AliRah1/lijn-volgende-robot/alirahhaoui_logboek_q6.pdf

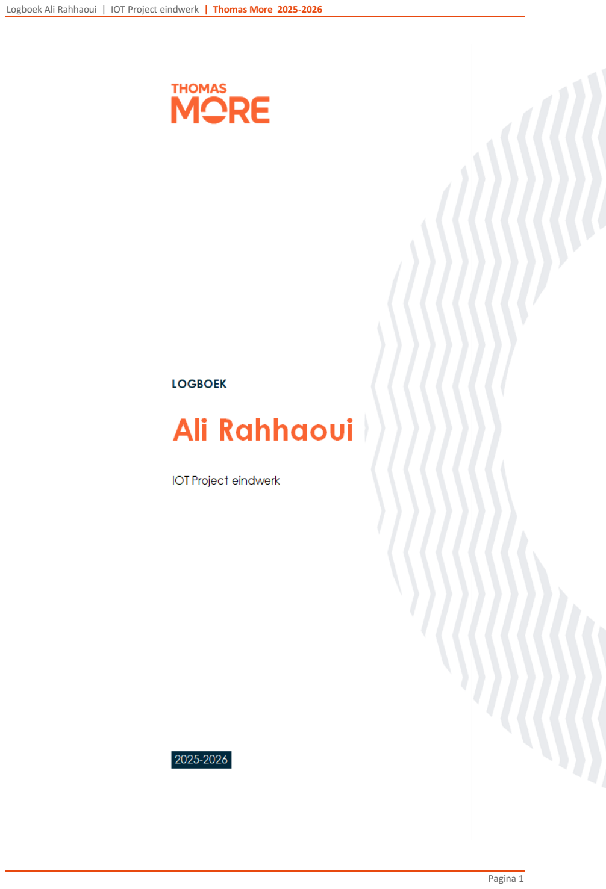
[picture p8: page 1]

Logboek Ali Rahhaoui | IOT Project eindwerk | Thomas More 2025-2026

## Instructies

Vul dit logboek 2x per week aan: elke dinsdag en vrijdag.

Wat er wordt gevraagd:

- Wat heb ik gedaan?
- Wat ging goed?
- Wat zou ik nu anders doen?
- Wat heb ik bijgeleerd?
- Wat plan ik de volgende periode te doen?

## 13. Vrijdag 5 juni 2026

Wat heb ik gedaan?
Alles getest en alles werkt. Nu nog wachten tot de examendag zelf.

Wat ging goed?
Alles ging goed zoals gepland.

Wat zou ik nu anders doen? /

Wat heb ik bijgeleerd?
/

Wat plan ik de volgende periode te doen? Presenteren op school.

## 12. Dinsdag 2 juni 2026

Wat heb ik gedaan?
Ik ben van start gegaan met het inladen van de huidige code op de ESP. En ook het klaarzetten van het Raspberry Pi.

Wat ging goed?
Alles ging in orde zoals gepland.

Wat zou ik nu anders doen?
/

Wat heb ik bijgeleerd?
/

Wat plan ik de volgende periode te doen? Alles nakijken, demo video maken en klaar.

## 11. Vrijdag 29 mei 2026

Wat heb ik gedaan?
Vandaag hebben we de diodes gekregen en zijn gestart met het solderen ervan.

Wat ging goed?
We zijn erna gaan testen en deze keer werkten de motoren wel en was alles in orde.

Wat zou ik nu anders doen?
/

Wat heb ik bijgeleerd?
/

Wat plan ik de volgende periode te doen?
Het Raspberry Pi klaarzetten en de juiste code toevoegen voor het robotje.

## 10. Dinsdag 26 mei 2026

Wat heb ik gedaan?
Het component is aangekomen en nu gaan we starten met het te solderen.

Wat ging goed?
Deze keer hebben we het juiste component dus is het in orde.

Wat zou ik nu anders doen?
Kijken wat nog meer ontbrak: we hebben 4 diodes nog nodig en nu moeten we weer wachten voor we opnieuw kunnen testen.

Wat heb ik bijgeleerd?
Dat ik als iets ontbreekt niet alleen naar één kant kijk, maar dat ik ook moet kijken wat ik nog meer nodig heb.

Wat plan ik de volgende periode te doen?
Als we de diodes hebben gaan we van start met het testen, en daarna het Raspberry Pi toevoegen en de juiste code op de ESP.

## 9. Vrijdag 22 mei 2026

Wat heb ik gedaan?
We zijn gestart met het testen van de PCB.

Wat ging goed?
Alle sensoren werken zoals het hoort.

Wat zou ik nu anders doen?
We hebben een verkeerde motor L298N besteld: we hadden het kant-en-klare kit gekocht terwijl we alleen de chip nodig hadden. Hierdoor werkt de PCB niet correct om de motor aan te sturen.

Wat heb ik bijgeleerd?
Altijd eerst goed bekijken wat je bestelt voor het componenten koopt.

Wat plan ik de volgende periode te doen?
We hebben de chip besteld en nu zijn we aan het wachten tot die aankomt.

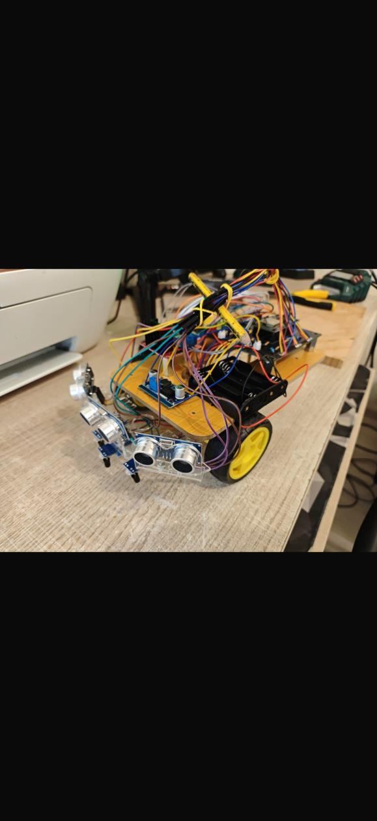
[picture p9: figure]

## 8. Dinsdag 19 mei 2026

Wat heb ik gedaan?
Ik en mijn teamlid zijn gestart met het solderen.

Wat ging goed?
Alles ging in orde.

Wat zou ik nu anders doen?
Beter geweest zijn om een soldeerstation thuis te hebben om veel tijd te besparen.

Wat heb ik bijgeleerd?
Hoe ik efficiënter moet solderen, want solderen is nog nieuw voor mij.

Wat plan ik de volgende periode te doen?
Na het solderen gaan we starten met het testen van de PCB.

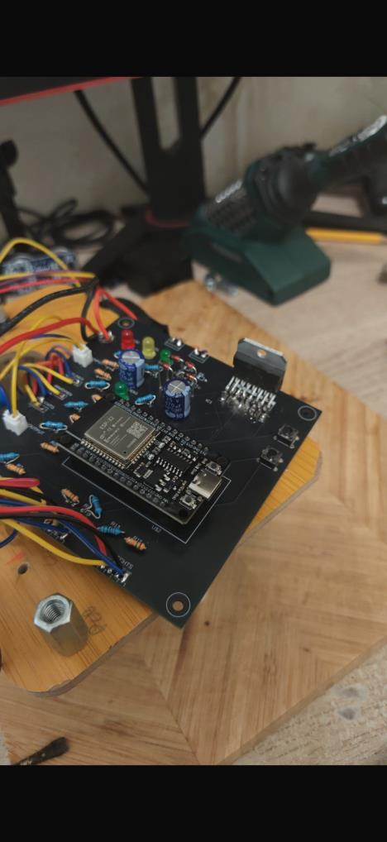
[picture p10: figure]

## 7. Vrijdag 15 mei 2026

Wat heb ik gedaan?
Vandaag is de PCB aangekomen maar we kunnen die nog niet solderen.

Wat ging goed?
/

Wat zou ik nu anders doen? /

Wat heb ik bijgeleerd?
/

Wat plan ik de volgende periode te doen?
We gaan volgende week van start gaan om te solderen.

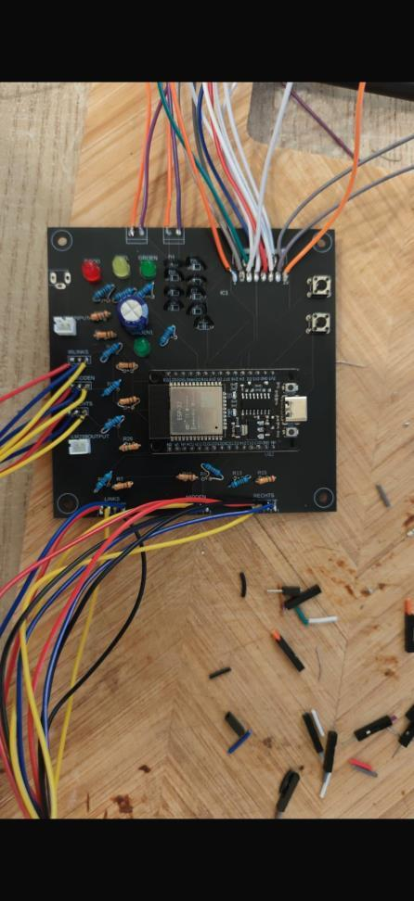
[picture p11: figure]

## 6. Dinsdag 12 mei 2026

Wat heb ik gedaan?
Ik en mijn teamlid zijn van start gegaan met het maken van het chassis, nu dat we toch aan het wachten zijn op de PCB.

Wat ging goed?
Alles ging in orde, we hadden de spullen die we nodig hadden om de taak uit te voeren.

Wat zou ik nu anders doen?
Niets, vandaag ging alles redelijk vlot.

Wat heb ik bijgeleerd?
/

Wat plan ik de volgende periode te doen?
Nu gaan we wachten op de PCB en als die aankomt, deze maken.

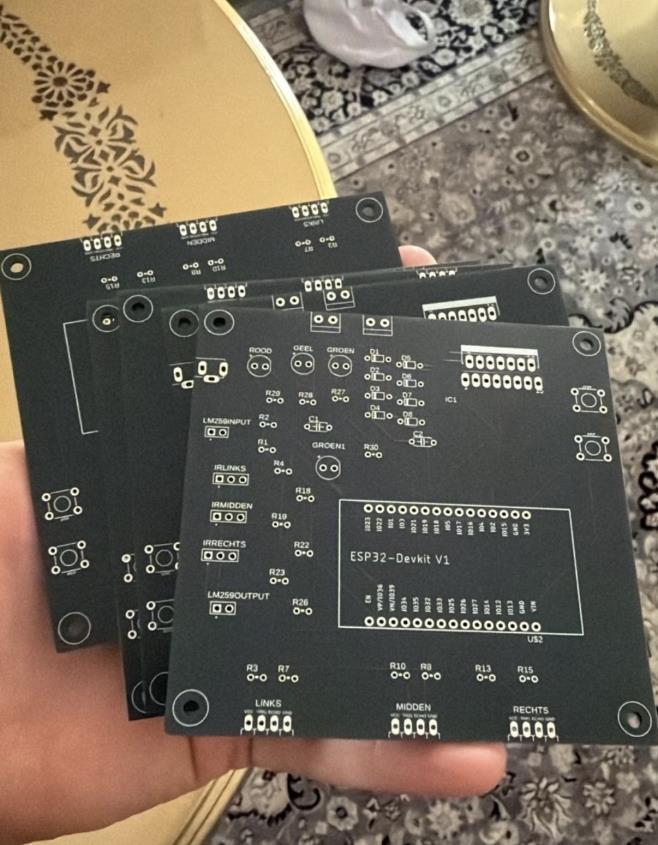
[picture p12: figure]

## 5. 08 mei 2026

Wat heb ik gedaan?
Ik heb goedkeuring gekregen van de leerkracht en heb de PCB besteld.

Wat ging goed?
De PCB was in orde.

Wat zou ik nu anders doen?
Ik zou beter de PCB samen met groepsleden hebben gekocht die het ook wilden, zo vermijden we extra kosten.

Wat heb ik bijgeleerd?
Dat het heel duur is om PCB's te kopen.

Wat plan ik de volgende periode te doen?
Ik en mijn teamlid gaan verder met het chassis en proberen af te maken voor de PCB aankomt, zodat we daarna alleen de PCB nog in orde moeten brengen.

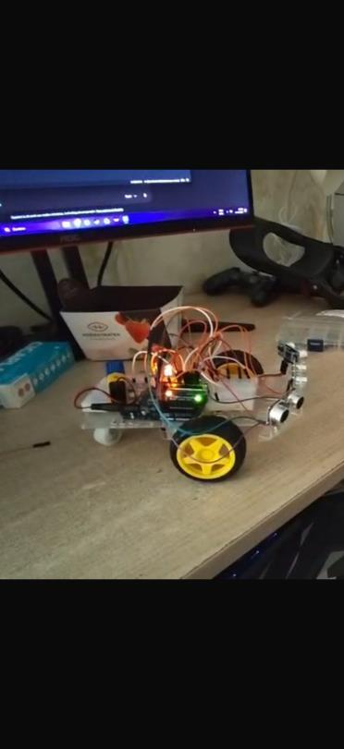
[picture p13: figure]

## 4. Dinsdag 5 mei 2026

Wat heb ik gedaan?
Ik heb de PCB afgekregen en nu wachten wij op de goedkeuring van de leerkracht.

Wat ging goed?
We hebben alles nagecheckt en goed nagekeken of alles in orde was en dat was ook zo.

Wat zou ik nu anders doen?
Niets, alles ging volgens plan.

Wat heb ik bijgeleerd?
Hoe ik PCB-draden groter kan maken en dat componentenplaatsing heel belangrijk is.

Wat plan ik de volgende periode te doen?
Als het goedgekeurd is, plan ik de PCB te bestellen.

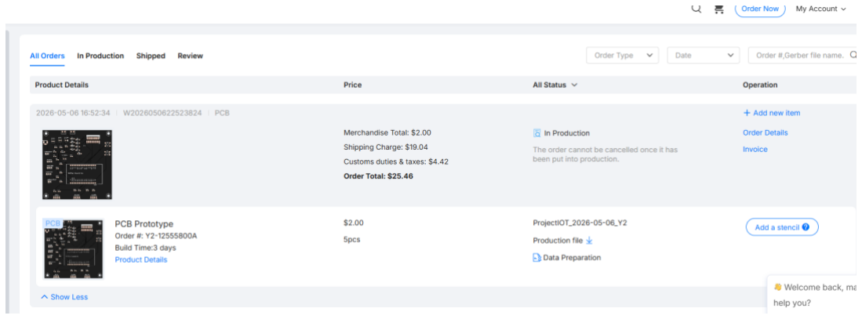
[picture p14: figure]

## 3. Vrijdag 1 mei 2026

Wat heb ik gedaan?
We hebben vandaag onze componenten gekregen en we zijn ons schema aan het verbeteren.

Wat ging goed?
Onze spullen zijn aangekomen dus kunnen we al van start gaan met het autootje op te bouwen.

Wat zou ik nu anders doen?
Niets.

Wat heb ik bijgeleerd?
Dat ik minder weerstanden moet zetten bij het schema.

Wat plan ik de volgende periode te doen?
Starten met de PCB en afwachten op de goedkeuring van de leerkracht.

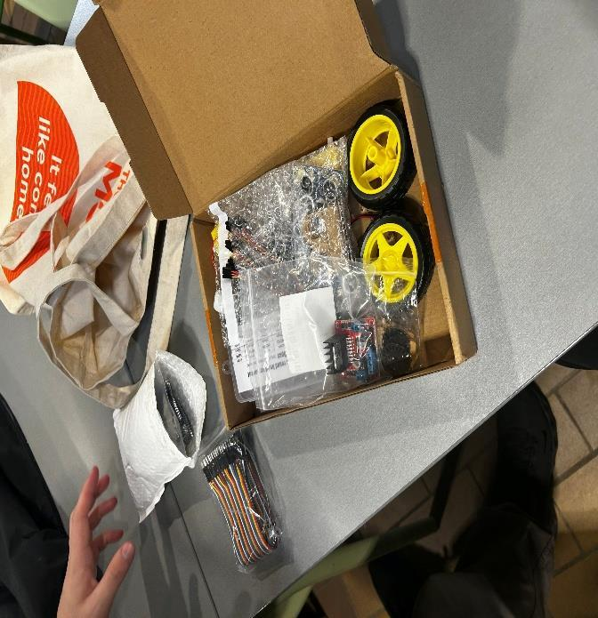
[picture p15: figure]

## 2. Dinsdag 28 april 2025

Wat heb ik gedaan?
We zijn gestart met het maken van een schema.

Wat ging goed?
We hebben alle componenten erop gekregen.

Wat zou ik nu anders doen?
Op voorhand misschien extra datasheets openen.

Wat heb ik bijgeleerd?
Dat datasheets heel belangrijk zijn.

Wat plan ik de volgende periode te doen? Schema afwerken en beginnen met PCB.

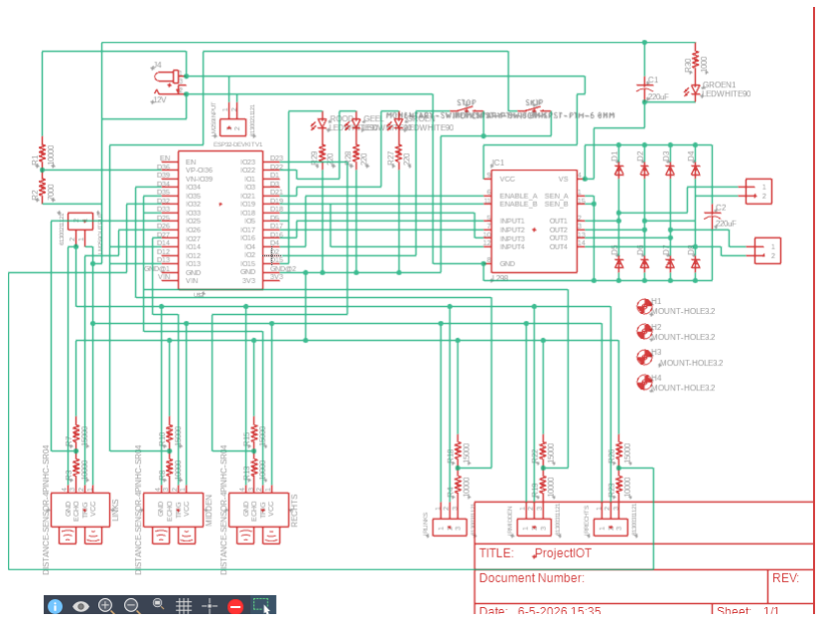
[picture p16: figure]

## 1. Vrijdag 24 april 2025

Wat heb ik gedaan?
We hebben vandaag alles besteld op AliExpress.

Wat ging goed?
We hebben alles kunnen vinden wat nodig is voor het project.

Wat zou ik nu anders doen?
Niets.

Wat heb ik bijgeleerd?
Niets.

Wat plan ik de volgende periode te doen? Starten met Fusion schema tekenen en PCB maken.

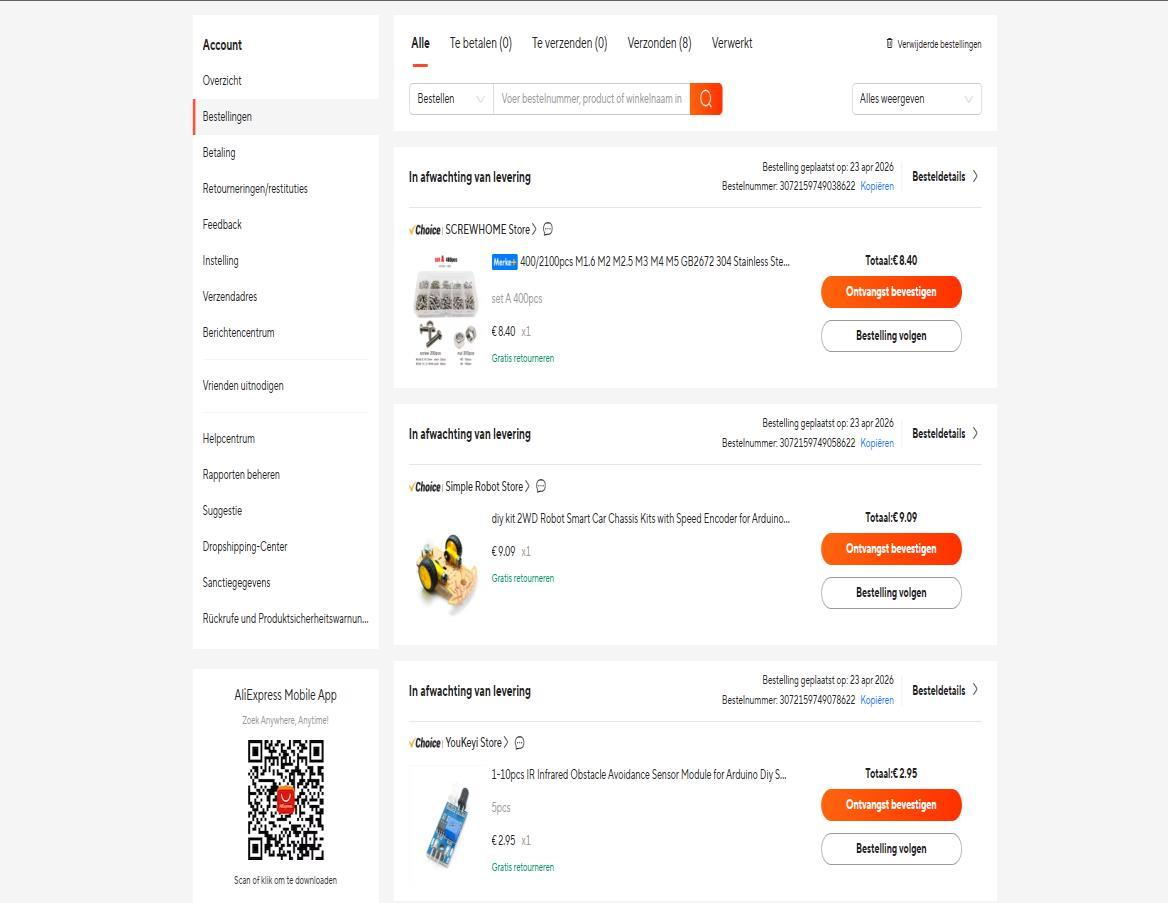
[picture p17: figure]
